loanagr/Temperature_sensor/Plots/Measurement_evaluation.pdf

## (a) Temperature evolution of calibration measurement

# Measurement evaluation

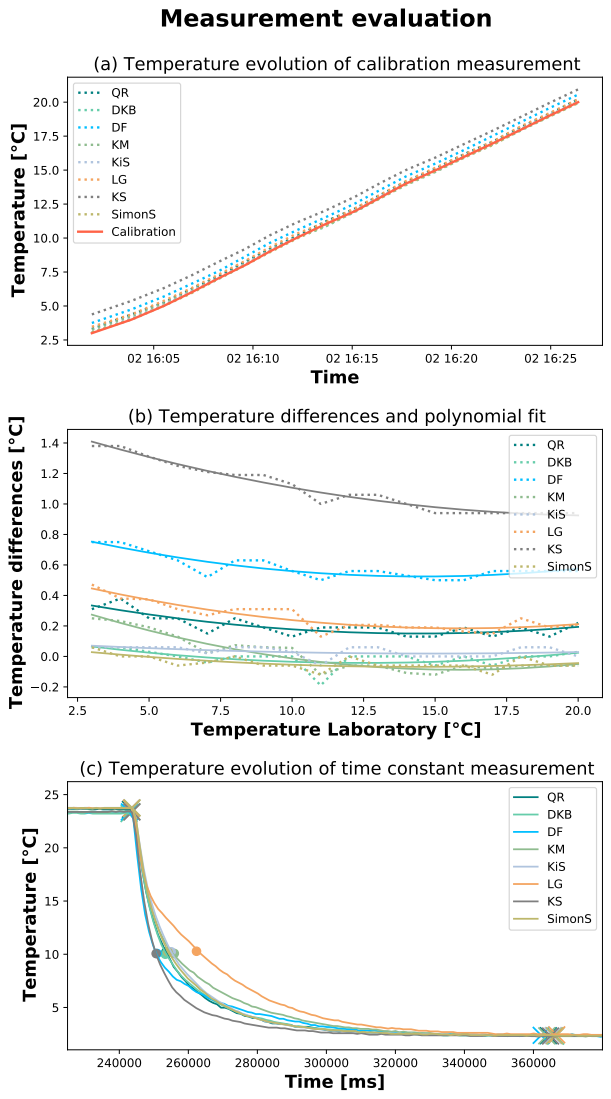
[picture p2: page 1]
Time; Temperature [°C]; QR DKB DF KM KiS LG KS SimonS Calibration; Temperature Laboratory [°C]; Temperature differences [°C]; QR DKB DF KM KiS LG KS SimonS; 240000 260000 280000 300000 320000 340000 360000 Time [ms]; (c) Temperature evolution of time constant measurement

(b) Temperature differences and polynomial fit
