loanagr/Temperature_sensor/Plots/Time_constant.pdf

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

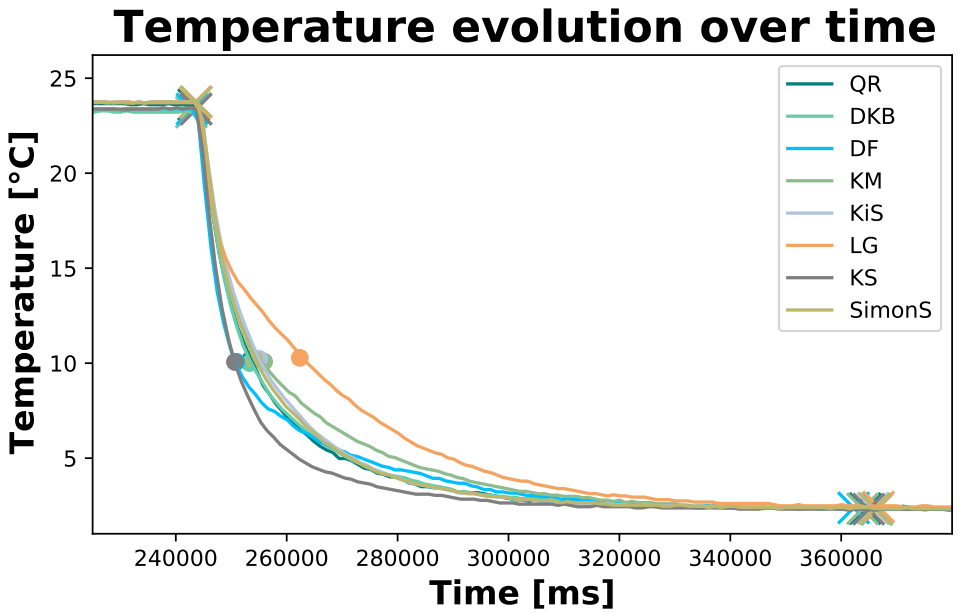
[picture p4: page 1]
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
