loanagr/Temperature_sensor/Plots/Circuit_Diagram.pdf

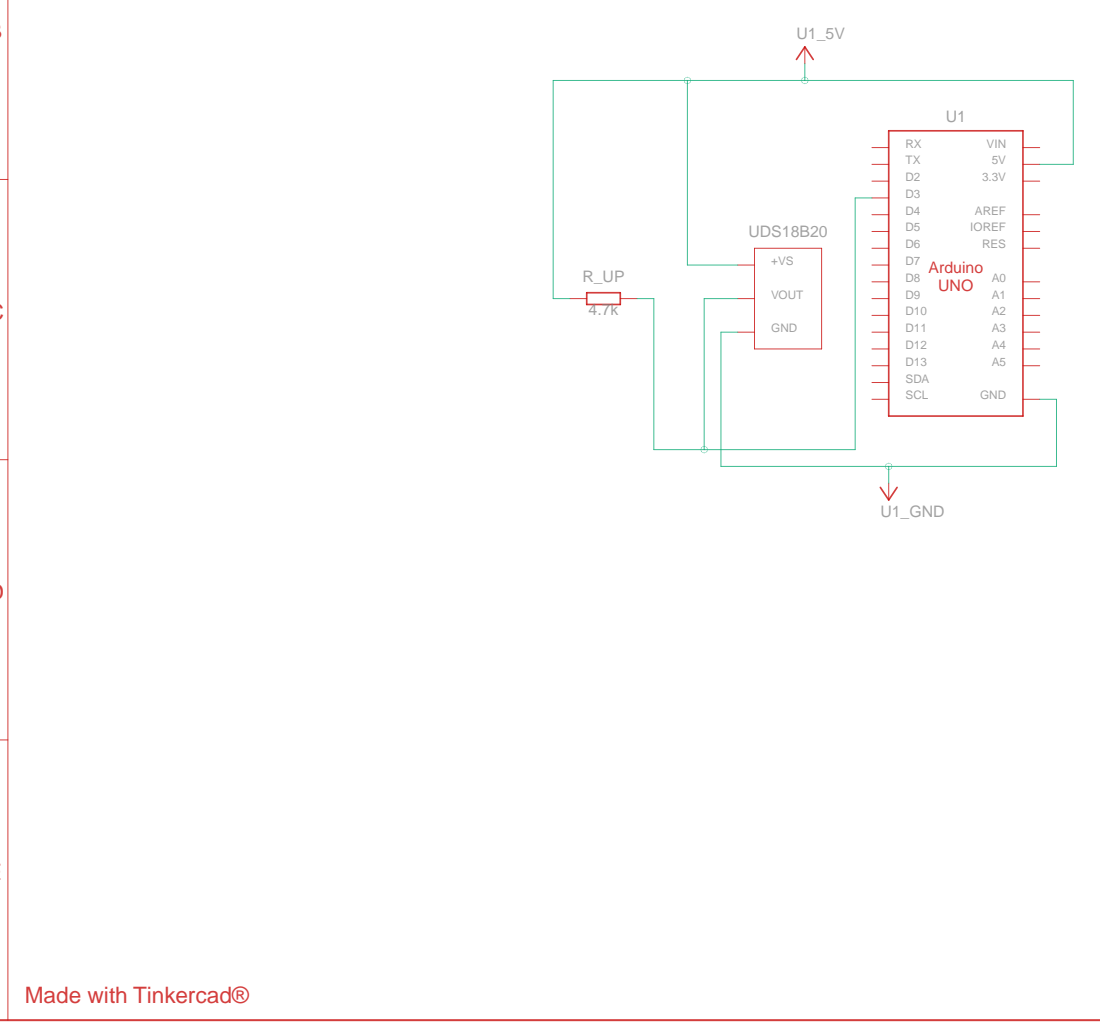
[picture p5: page 1]

Title: Super Inari-Crift
