loanagr/Temperature_sensor/(commit log)

2023-03-01 Add circuit diagram
2023-03-02 Include temperature sensor data sheer and helper functions
2023-03-06 Evaluate temperature measurements, update files to same time axis
    [TSENSOR_DKB_ne.csv, TSENSOR_DKB_new.csv]
2023-03-06 Finish calibration and time constant evaluation
2023-03-07 Integrate average measurement and time interval into Arduino code
2023-03-10 Create code block for calibration
2023-03-10 Create code block for calibration and time constant
2023-03-10 Create & store plots of the calibration and time constant
2023-03-12 Include report, delete old measurement and sketch files
    [TSENSOR_DKB_ne.csv, TSENSOR_DKB_new.csv]
